gignaWedi/Tetrikinesis/README.md

# BME 349: Tetrikinesis
This project created a wearable (Tetrikinesis) that used interial measurments, gyroscopic measurments, and a myosensor to interface with a computer to play games, like Tetris.

## Members
- Lauren Adams
- Emily Yemington
- Siem Yonas

## Project Video
Project Video (https://youtu.be/_jhFtWAOiB0)
