gignaWedi/Tetrikinesis/Schematics-CAD/TK_CAD_render.png

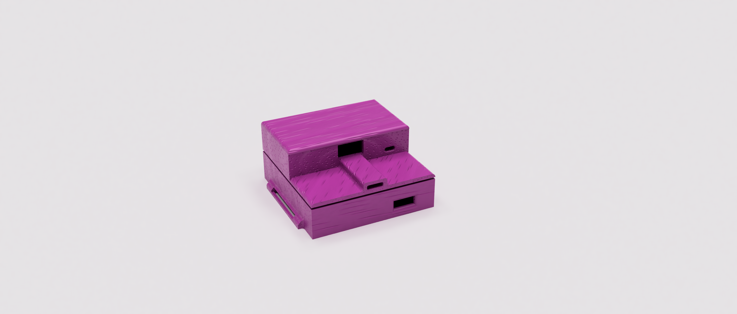
Schematics-CAD/TK_CAD_render.png
