gignaWedi/Tetrikinesis/Schematics-CAD/TK_Electrical_Schematic.png

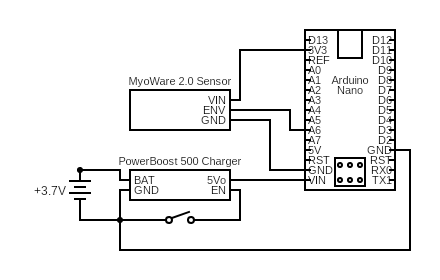
Schematics-CAD/TK_Electrical_Schematic.png
