gignaWedi/Tetrikinesis/Schematics-CAD/TK bottom layer.pdf

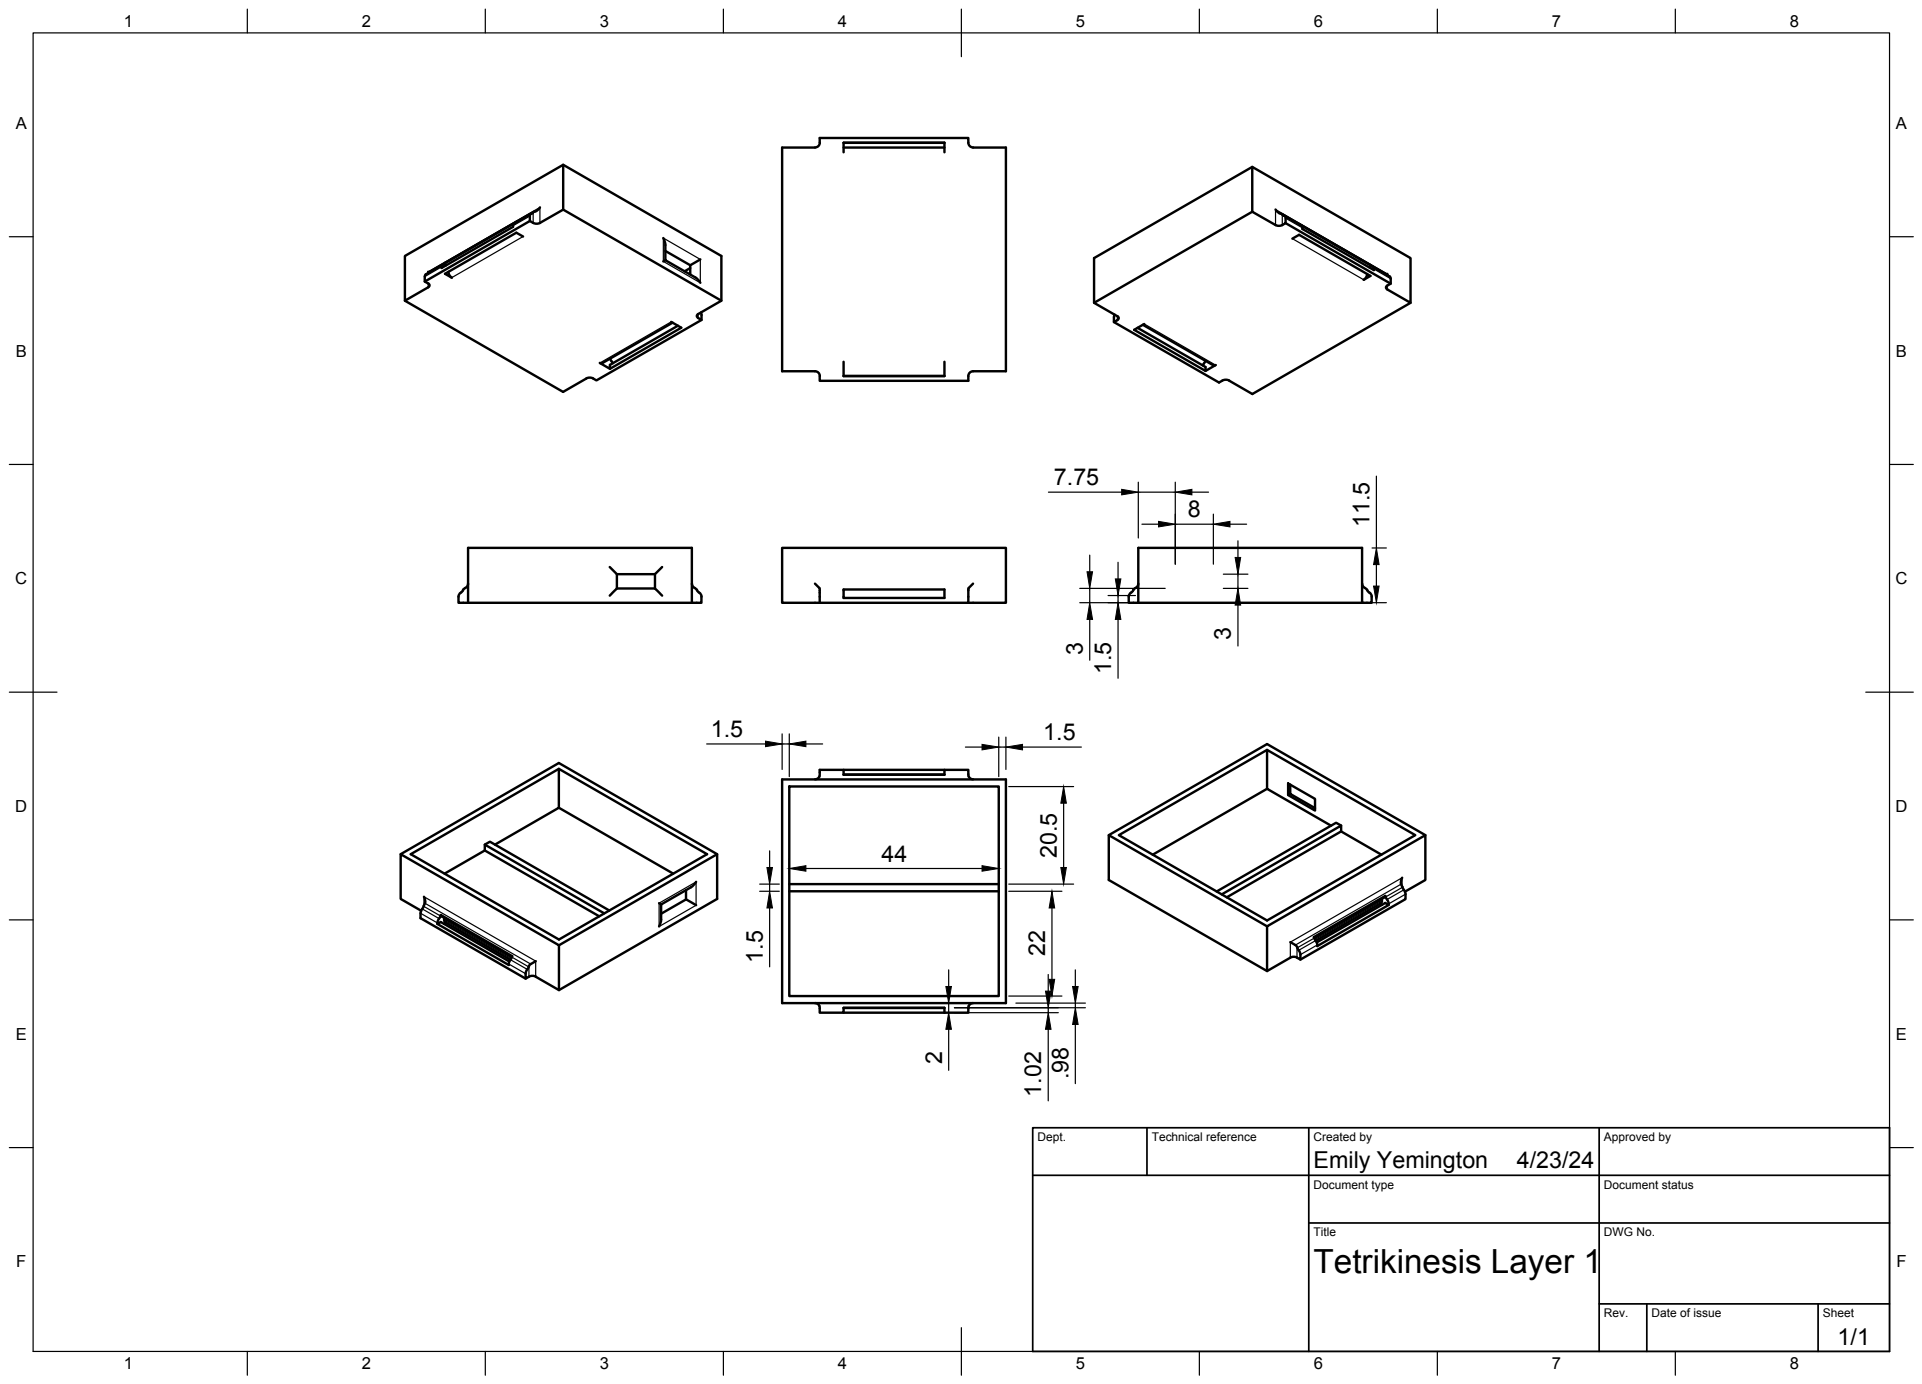
[picture p8: page 1]
Title; DWG No.; Rev.; Date of issue; Sheet; Tetrikinesis Layer 1; Emily Yemington 22 20.5 1.5

Dept. | Technical reference | Created by 4/23/24 | Approved by

Document type | Document status
