gignaWedi/Tetrikinesis/Schematics-CAD/TK layer 2.pdf

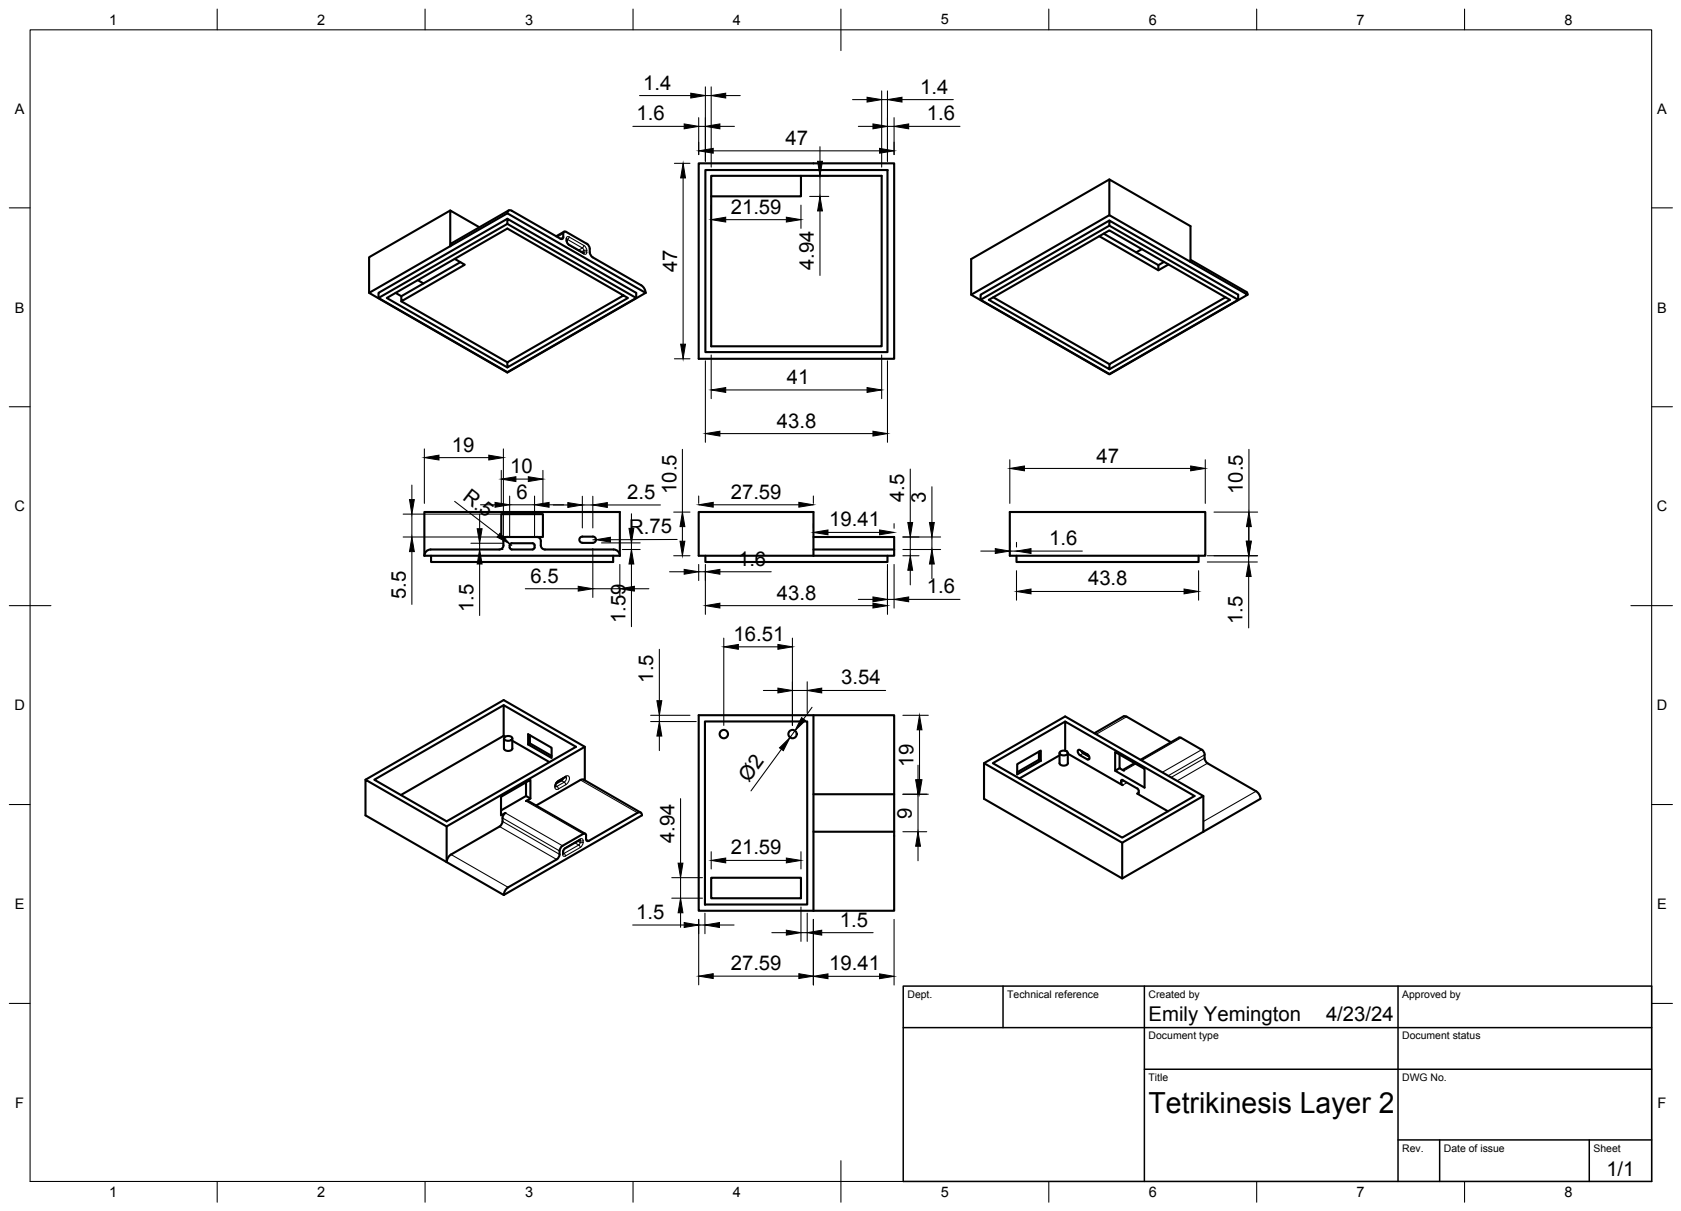
[picture p9: page 1]
Title; DWG No.; Rev.; Date of issue; Sheet; Tetrikinesis Layer 2

Dept. | Technical reference | Created by Emily Yemington 4/23/24 | Approved by

Document type | Document status
