gignaWedi/Tetrikinesis/Schematics-CAD/TK_CAD_Drawing.pdf

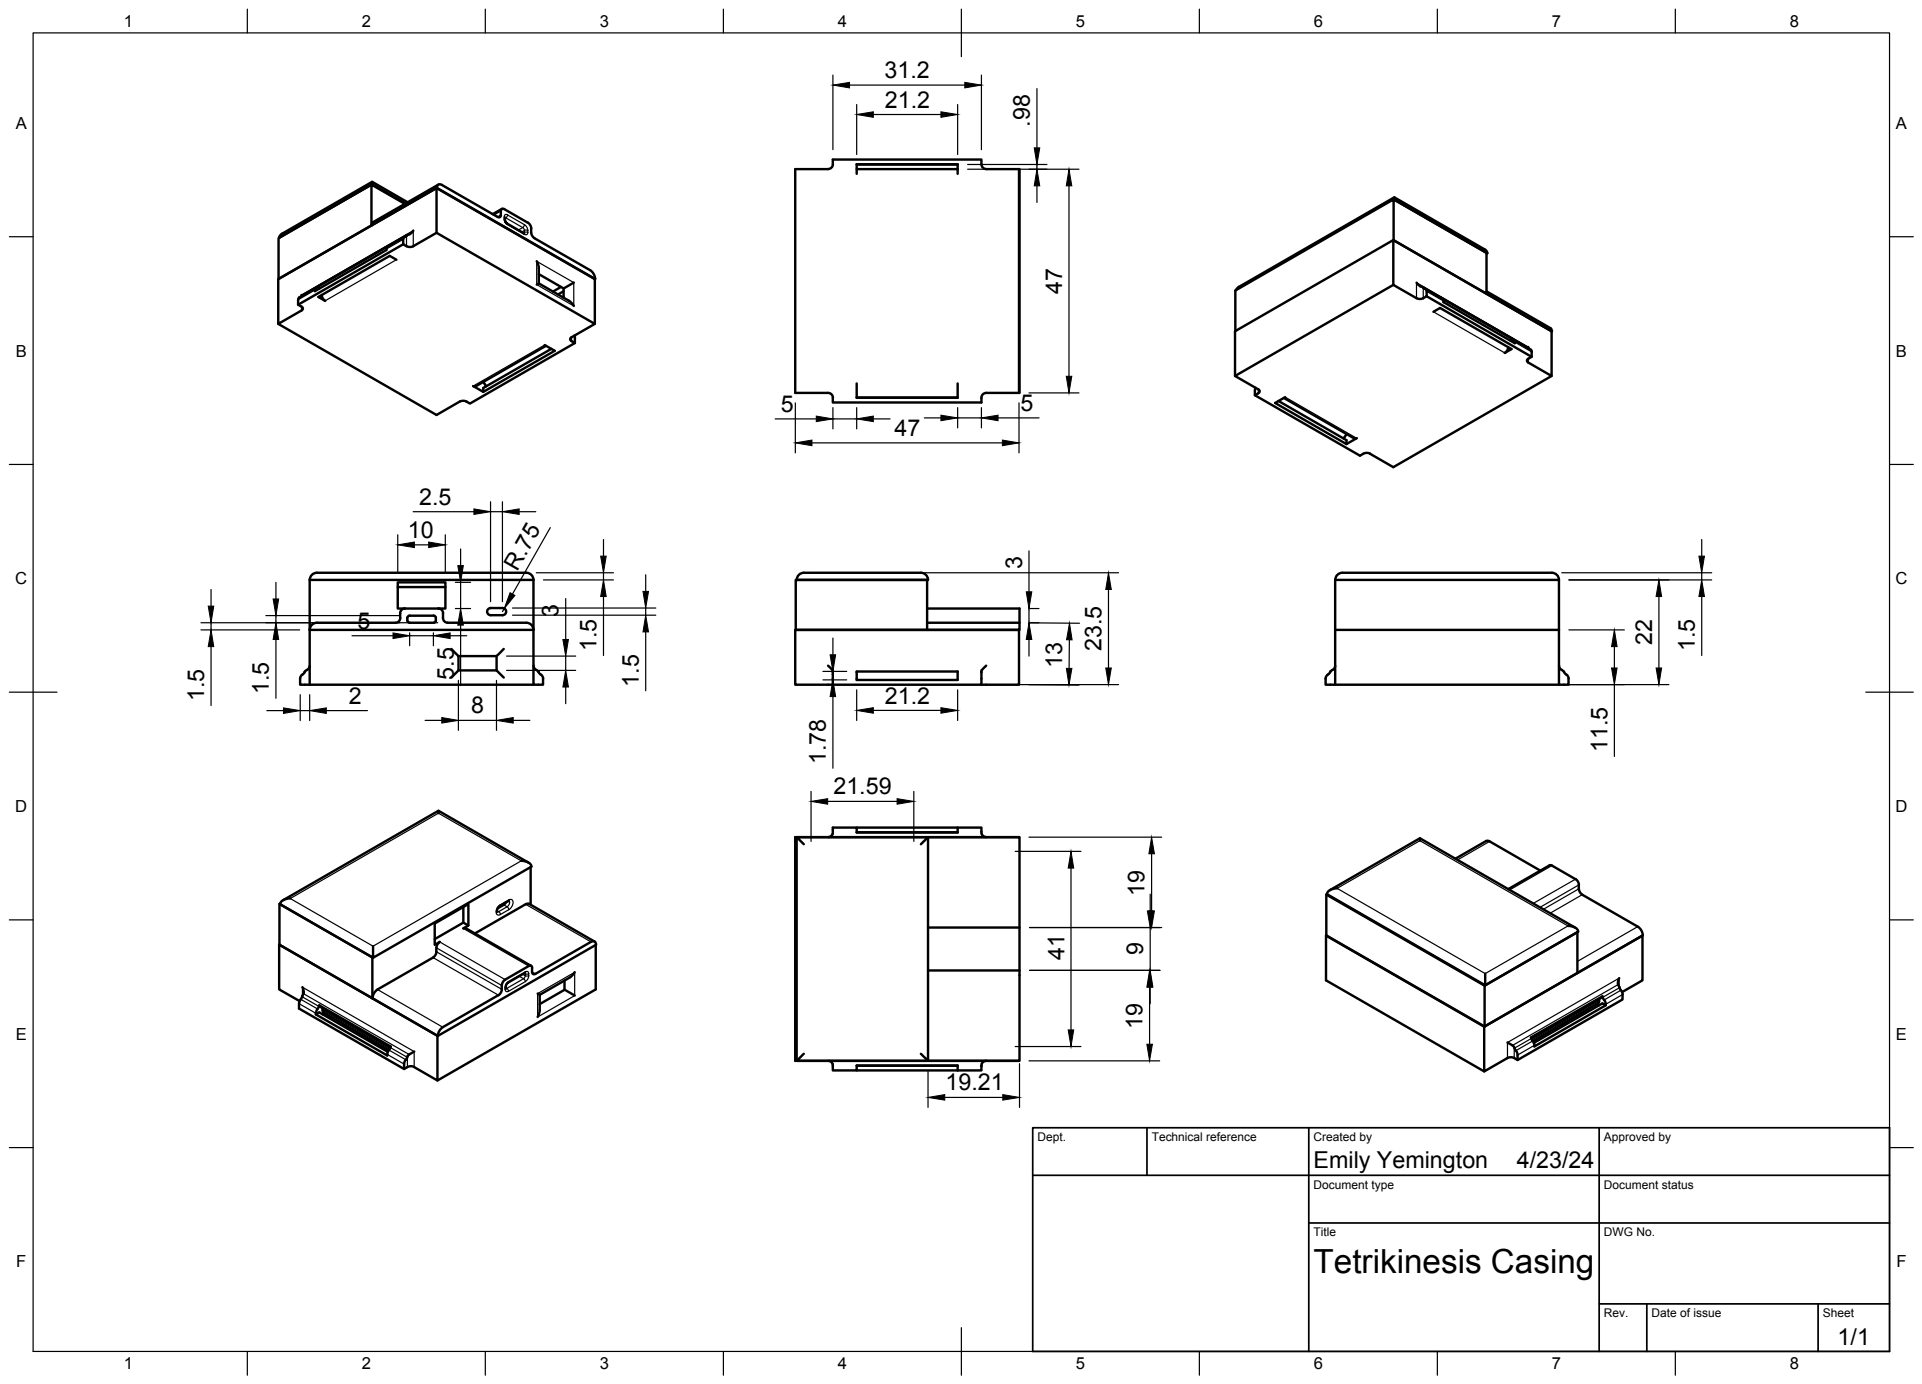
[picture p10: page 1]
Title; DWG No.; Rev.; Date of issue; Sheet; Tetrikinesis Casing

Dept. | Technical reference | Created by Emily Yemington 4/23/24 | Approved by

Document type | Document status
